elutsk/open-bike-light/README.UA.md

# Open Bike Light - схема та прошивка для ATtiny13A

Прошивка заднього ліхтаря для велоклубу, схема ревізії `circuit2`.
Це переклад файлу `README.md`. Якщо тексти розходяться, правильним вважається англійський.

Документ має дві частини:

1. **Інструкція користувача** - як користуватися ліхтарем.
2. **Інструкція для збирача** - як налаштувати програми, прошити, відкалібрувати й перевірити плату.

Назви меню Arduino IDE наведено англійською, як вони виглядають у мові інтерфейсу за замовчуванням.

---

# Частина 1. Інструкція користувача

## 1.1 Що це

Задній велоліхтар з одним червоним світлодіодом, однією кнопкою і вбудованим
Li-ion акумулятором, який заряджається через USB-C. Ліхтар має 5 режимів світла,
розділених на 2 групи ("блоки"), запам'ятовує останній режим, показує рівень
заряду і сам захищає акумулятор від глибокого розряду.

## 1.2 Кнопка

Кнопка одна. Вона розрізняє три види натискань:

| Натискання | Назва | Як зробити |
|---|---|---|
| Коротке | SP | Натиснути й відпустити швидше ніж за 1 секунду. |
| Подвійне | DP | Два коротких натискання поспіль; друге треба почати не пізніше ніж через 0,3 с після того, як відпустили перше. |
| Довге | LP | Утримувати кнопку 1 секунду. Ліхтар реагує ще поки кнопка натиснута, після цього її можна відпустити. |

Коли ліхтар увімкнений, коротке натискання спрацьовує приблизно через 0,3 с після
відпускання кнопки (ліхтар чекає, чи не буде другого натискання).

## 1.3 Ліхтар вимкнений

| Натискання | Що відбувається |
|---|---|
| SP | Показує рівень заряду (див. 1.5). |
| DP | Нічого особливого (сприймається як два коротких натискання: рівень заряду показується двічі). |
| LP | Вмикає ліхтар у режимі, який використовувався востаннє. Найперший раз вмикається Блок 1, режим 1 (Eco). |

Під час увімкнення спершу перевіряється акумулятор:

1. Заряд нижче 10%: ліхтар вмикається в режимі Eco і лишається в ньому (див. 1.6).
2. Акумулятор порожній: світлодіод дає **один короткий тьмяний спалах**, і ліхтар
   лишається вимкненим. Це означає, що ліхтар справний, але акумулятор треба зарядити.

## 1.4 Ліхтар увімкнений

| Натискання | Що відбувається |
|---|---|
| SP | Наступний режим у поточному блоці (після останнього знову перший). |
| DP | Перехід на інший блок, завжди з його першого режиму. |
| LP | Запам'ятовує поточні блок і режим і вимикає ліхтар. |

### Блок 1 - блимання (найкраще вдень, щоб вас було видно)

| Режим | Назва | Як світить |
|---|---|---|
| 1 | Eco | Один короткий спалах (50 мс) щосекунди. Найменше витрачає акумулятор. |
| 2 | Normal | Серія з трьох коротких спалахів, потім пауза 0,6 с. |
| 3 | Hi-vis | Довгий спалах 0,2 с, пауза 0,4 с. |

### Блок 2 - постійне світло (для групових поїздок, щоб не сліпити того, хто їде позаду)

| Режим | Назва | Яскравість |
|---|---|---|
| 1 | Ride | 50% |
| 2 | Beam | 100% |

Яскравість лишається однаковою, поки акумулятор розряджається від повного до
приблизно 25%. Нижче 25% ліхтар поступово тьмяніє.

## 1.5 Рівень заряду

Коли ліхтар **вимкнений**, зробіть коротке натискання. Основний світлодіод покаже:

| Що видно | Заряд |
|---|---|
| 4 яскраві спалахи | 75..100% |
| 3 яскраві спалахи | 50..75% |
| 2 яскраві спалахи | 25..50% |
| 1 тьмяний спалах | менше 25% - скоро заряджати |

Рівні відповідають реальній кривій розряду Li-ion акумулятора, а не просто лінійній
шкалі напруги, тож "половина" справді означає, що лишилося приблизно пів часу їзди.
Найточніше показання буде, якщо ліхтар перед цим постояв вимкненим хоча б хвилину.

## 1.6 Низький заряд і порожній акумулятор

1. **Нижче 10%** ліхтар сам перемикається в режим Eco і не дає вибрати інші режими,
   доки його не вимкнуть. Так задумано: Eco дає найдовший час, щоб доїхати додому хоч
   з якимось світлом. Якщо ліхтар не реагує на натискання, причина саме в цьому.
   Ваш улюблений режим при цьому все одно запам'ятовується.
2. **Порожній** (акумулятор дійшов до безпечного мінімуму): ліхтар вимикається сам,
   без попереджувального спалаху. Зарядіть акумулятор.

## 1.7 Заряджання

1. Вставте кабель USB-C у ліхтар. Підійде будь-який USB-зарядний пристрій або порт
   комп'ютера, зокрема кабелі USB-C - USB-C.
2. Один маленький індикатор показує "заряджається", інший - "заряджено". Якщо
   акумулятор не підключений, обидва можуть блимати; це нормально.
3. Повне заряджання розрядженого акумулятора триває приблизно 3 години при струмі
   заряду за замовчуванням (175 мА).
4. Користуватися ліхтарем під час заряджання можна, але тоді зарядний контролер
   може так і не визначити, що акумулятор повний. Для нормального повного заряду
   вимкніть ліхтар.

## 1.8 Зберігання

Вимкнений ліхтар майже не споживає енергії і може місяцями лежати в сумці.
Для тривалого зберігання зарядіть його приблизно наполовину (2 або 3 спалахи)
і перевіряйте раз на кілька місяців.

---

# Частина 2. Інструкція для збирача

## 2.1 Правила безпеки - прочитати спершу

1. **Ніколи не живіть плату від програматора.** VCC з'єднаний напряму з Li-ion
   акумулятором. 5 В від програматора йдуть прямо в акумулятор.
   На USBasp зніміть перемичку живлення цілі ("target power"). Тримайте окремий
   клубний ISP-кабель з перерізаним і підписаним дротом VCC. Програматори, які
   лише *вимірюють* напругу цілі (AVRISP mkII, Atmel-ICE), безпечні як є.
2. **Ніколи не програмуйте ф'юзи RSTDISBL і WDTON.** RSTDISBL вимикає ISP (відновити
   чип можна лише високовольтним програматором). WDTON робить неможливим вимкнення
   watchdog перед сном. Налаштування Arduino нижче їх ніколи не встановлюють; не
   редагуйте ф'юзи вручну.
3. Використовуйте **лише захищені акумулятори** (з власною платою захисту).
4. Для найпершого ввімкнення нової плати замість акумулятора використайте
   лабораторний блок живлення 3,7 В з обмеженням струму близько 100 мА.

## 2.2 Що потрібно

1. Комп'ютер з **Arduino IDE 2.3.6**.
2. ISP-програматор: USBasp (зі знятою перемичкою живлення), USBtinyISP (що не
   живить ціль), AVRISP mkII або Atmel-ICE.
3. **Кліпса SOIC-8** з кабелем до 6- або 10-контактного ISP-роз'єму програматора.
4. Заряджений захищений Li-ion акумулятор, підключений до плати (під час
   програмування плата живиться від власного акумулятора).
5. Мультиметр (для калібрування).

## 2.3 Встановлення програм (один раз на комп'ютер)

1. Встановіть Arduino IDE 2.3.6 з arduino.cc.
2. Відкрийте **File > Preferences**. У полі **Additional boards manager URLs** додайте:
   `https://mcudude.github.io/MicroCore/package_MCUdude_MicroCore_index.json`
   (якщо там уже є адреса, додайте нову з нового рядка). Натисніть OK.
3. У тому ж вікні Preferences поставте галочку **Show verbose output during: upload**.
   Вона знадобиться для калібрування.
4. Відкрийте **Tools > Board > Boards Manager**, знайдіть **MicroCore**, виберіть
   версію **2.5.2** і натисніть Install.
5. У Windows для USBasp може знадобитися USB-драйвер (наприклад, встановлений
   програмою Zadig, драйвер "libusbK" або "WinUSB"). У Linux може знадобитися
   правило udev, щоб працювати з програматором без root.

## 2.4 Відкриття проєкту

1. Папка має називатися `OpenBikeLight` і містити `OpenBikeLight.ino`
   (Arduino вимагає, щоб назви папки й .ino-файлу збігалися).
2. Відкрийте `OpenBikeLight.ino` в Arduino IDE.

## 2.5 Параметри конкретної збірки

На початку `OpenBikeLight.ino` є блок **PER-BUILD PARAMETERS**. Перевіряйте його
для кожної збірки. Усе нижче рядка "INTERNALS" лишається без змін.

| Параметр | За замовчуванням | Значення |
|---|---|---|
| `LED_VF_MV` | 2300 | Пряма напруга основного світлодіода в мВ при робочому струмі. Червоні світлодіоди: 2100..2400. |
| `LED_VFULL_MV` | 3720 | Напруга акумулятора, при якій світлодіод досягає повної яскравості на 100% ШІМ. R9 розраховується саме для цієї напруги. Тримайте рівною `BAT_25_MV`, якщо немає вагомої причини інакше. |

### Вибір R9

R9 - єдина деталь, яку збирач змінює під свій світлодіод. Виберіть бажаний
струм світлодіода (`I`, в амперах) і порахуйте:

`R9 = (LED_VFULL_MV - LED_VF_MV) / 1000 / I`

Приклад: червоний світлодіод 1 Вт, Vf = 2,3 В, 150 мА: R9 = (3,72 - 2,30) / 0,150 = 9,5 Ом,
беремо 10 Ом (виходить 142 мА).

Потім перевірте дві речі:

1. **Піковий струм світлодіода** при повному акумуляторі: `(4,2 - Vf) / R9`. Для
   10 Ом це 190 мА. Світлодіод має витримувати такий імпульсний струм.
2. **Нагрів R9**: `I x (4,2 - Vf)` ват, найгірший випадок при повному акумуляторі.
   Для 10 Ом: 0,142 x 1,9 = 0,27 Вт. Використовуйте резистор 2512 (або два
   послідовно, щоб розподілити тепло).

Типові струми світлодіодів (якщо не впевнені, беріть менше значення):

| Тип світлодіода | Струм на один світлодіод |
|---|---|
| 5 мм, вивідний | 20 мА |
| SMD 3528 | 20 мА |
| SMD 5050 (3 кристали) | 60 мА |
| "Піранья" / superflux, 4 ніжки | 50..70 мА |
| SMD 2835 | 60..150 мА |
| 0,5..1 Вт на "зірці" | 150..350 мА |

Приклад для 5 мм червоного світлодіода на 20 мА, Vf = 2,0 В: R9 = (3,72 - 2,00) / 0,020 =
86 Ом, беремо 82 або 91 Ом, а `LED_VF_MV` встановлюємо 2000.

**Резистор 10 Ом за замовчуванням спалить маленькі світлодіоди (5 мм, 3528).**
Завжди спершу підберіть R9.

Якщо кілька світлодіодів увімкнені паралельно, кожному потрібен свій резистор.

## 2.6 Налаштування Arduino - мають бути точними

Підключіть програматор до комп'ютера, потім у меню **Tools** встановіть:

| Меню | Значення |
|---|---|
| Board | MicroCore > **ATtiny13** |
| BOD | **BOD 2.7V** |
| EEPROM | **EEPROM retained** |
| Clock | **9.6 MHz internal osc.** |
| Bootloader | **No bootloader** |
| Programmer | ваш програматор, наприклад **USBasp** (не "slow") |

Ці налаштування визначають ф'юзи: low fuse **0x3A**, high fuse **0xFB**.

**Важливо:** у MicroCore кожен "Upload Using Programmer" знову записує ф'юзи з цих
меню, не лише "Burn Bootloader". Якщо під час завантаження якесь меню виставлене
неправильно, чип отримає неправильні ф'юзи. Перевіряйте меню щоразу.

## 2.7 Перевірка компіляції

Натисніть **Verify** (кнопка з галочкою). Наприкінці виводу має бути розмір у flash,
приблизно **996 з 1024 байт**. Якщо пише, що скетч завеликий, щось не так у
налаштуваннях (не та плата чи частота) або змінено код.

## 2.8 Підключення програматора

1. Переконайтеся, що програматор **не** живить плату (розділ 2.1).
2. Підключіть до плати заряджений акумулятор (або лабораторний блок живлення).
3. Надягніть кліпсу SOIC-8 на U1. **Перший контакт** кліпси (зазвичай червоний
   дріт) має бути на ніжці 1 ATtiny13A (кут з крапкою на корпусі). Кліпса має
   сидіти рівно, всі 8 контактів на ніжках.
4. Під час програмування світлодіод може блимати. Це нормально: лінія MOSI - це
   також затвор транзистора світлодіода.

## 2.9 Перше програмування нового чипа

Виконайте ці кроки саме в такому порядку, один раз для кожного нового чипа:

1. **Tools > Burn Bootloader.** З "No bootloader" це лише записує ф'юзи
   (9,6 МГц, BOD 2,7 В, EEPROM retained). Також стирає чип.
   Дочекайтеся "Done burning bootloader".
2. **Sketch > Upload Using Programmer** (Ctrl+Shift+U). Дочекайтеся "Done uploading".
   Не користуйтеся звичайною кнопкою "Upload".
3. Зніміть кліпсу.
4. Відкалібруйте (розділ 2.11).
5. Перевірте (розділ 2.12).

## 2.10 Оновлення прошивки згодом

Лише крок 2 з 2.9: **Sketch > Upload Using Programmer**, з меню, встановленими як у 2.6.
Калібрування і збережений режим лишаються в EEPROM завдяки "EEPROM retained".

## 2.11 Калібрування (один раз на плату)

### Навіщо

ATtiny13A міряє акумулятор відносно внутрішнього опорного джерела 1,1 В. Це
джерело відрізняється від чипа до чипа до +-10%. Без калібрування показання
акумулятора може помилятися до 0,4 В, і тоді неправильно працюють індикатор заряду,
перемикання на низький заряд і відсічка. Одне число в EEPROM це виправляє.

### Як це працює

Щоразу, коли ви робите коротке натискання при вимкненому ліхтарі (індикація заряду),
прошивка зберігає в EEPROM своє сире показання акумулятора (`SUM`). Ви міряєте той
самий акумулятор мультиметром, зчитуєте `SUM` з чипа програматором, рахуєте
калібрувальний коефіцієнт `SCALE` і записуєте його назад.

### Крок 1 - знайдіть свою команду avrdude

Усередині Arduino IDE є avrdude. Найпростіше отримати правильну команду так:

1. Переконайтеся, що "Show verbose output during upload" увімкнено (розділ 2.3).
2. Зробіть "Upload Using Programmer".
3. У вікні виводу знайдіть довгий рядок, що починається зі шляху до `avrdude` і
   містить `-C` та `-p attiny13a` (або `-pattiny13a`). Скопіюйте: шлях до avrdude,
   частину `-C...` з файлом конфігурації, частину `-p...` і частину `-c...`
   (програматор).

Далі це позначено так:

```
"<AVRDUDE>" "-C<CONFIG>" -pattiny13a -c<PROGRAMMER>
```

Замініть це тим, що ви скопіювали. Команди запускайте в терміналі
(Windows: Command Prompt; macOS/Linux: Terminal).

### Крок 2 - зніміть показання

1. Зніміть кліпсу. Акумулятор підключений, ліхтар **вимкнений**.
2. Зачекайте щонайменше хвилину після того, як ліхтар востаннє світив.
3. Виміряйте напругу акумулятора мультиметром **прямо на контактах акумулятора**
   на платі (BT1 + і -). Запишіть її в **мілівольтах**, наприклад 3987 мВ.
   Використовуйте мультиметр, що показує щонайменше 3 знаки після коми у вольтах.
4. Зробіть **одне коротке натискання**. Світлодіод покаже рівень заряду, і в цей
   самий момент прошивка збереже `SUM` в EEPROM.
5. Виміряйте напругу ще раз. Якщо вона відрізняється від першого значення, візьміть
   середнє.

### Крок 3 - зчитайте SUM з чипа

1. Надягніть кліпсу (програматор не живить плату).
2. Виконайте:

```
"<AVRDUDE>" "-C<CONFIG>" -pattiny13a -c<PROGRAMMER> -U eeprom:r:eeprom.txt:h
```

3. Відкрийте `eeprom.txt` (він у папці, з якої ви запускали команду). Там 64 байти
   EEPROM по порядку, починаючи з байта 0, приблизно так (точне розбиття на рядки
   може відрізнятися в різних версіях avrdude):

```
0xff,0xff,0x8a,0x0c,0x03,0xff,...
```

Байти 0 і 1 - калібрувальний коефіцієнт (0xff,0xff = ще не відкалібровано),
**байти 2 і 3 - це SUM** (молодший байт першим), байт 4 - збережений режим світла.

У цьому прикладі SUM = 0x0C8A. Переведіть у десяткову систему: 0x0C8A = 3210
(калькулятор Windows у режимі "Програміст" це вміє).

### Крок 4 - порахуйте SCALE

```
SCALE = Vbat_мВ x 16384 / SUM
```

Приклад: 3987 x 16384 / 3210 = 20350 (округліть до цілого).

**Перевірка:** SCALE має бути між **17874 і 23518**. Номінальне значення 20696.
Значення поза цим діапазоном означає помилку (не та одиниця напруги, переплутані
байти, неправильне показання); прошивка ігнорує таке значення і використовує
номінальне опорне джерело.

Переведіть SCALE у шістнадцяткову систему: 20350 = 0x4F7E. **Молодший байт** 0x7E,
**старший байт** 0x4F.

### Крок 5 - запишіть SCALE

```
"<AVRDUDE>" "-C<CONFIG>" -pattiny13a -c<PROGRAMMER> -U eeprom:w:0x7E,0x4F:m
```

Спершу молодший байт, потім старший. Це записує адреси EEPROM 0 і 1. Деякі версії
avrdude при цьому можуть скинути інші байти EEPROM (збережений режим, SUM); це
нешкідливо, просто наступного разу ліхтар увімкнеться в Eco.

### Крок 6 - перевірте

1. Ще раз зчитайте EEPROM (крок 3) і перевірте, що байти 0 і 1 - ваші значення.
2. Зніміть кліпсу. Коли avrdude закінчує роботу, він відпускає RESET, тож чип сам
   перезапускається і зчитує новий калібрувальний коефіцієнт.
3. Зробіть коротке натискання при вимкненому ліхтарі і перевірте, що кількість
   спалахів відповідає показанню мультиметра і таблиці в 2.13.

Запишіть значення SCALE на платі. Якщо чип колись втратить вміст EEPROM, те саме 
значення можна записати знову без вимірювань.

## 2.12 Перевірка після збирання

1. **Струм сну.** Ліхтар вимкнений, мультиметр у діапазоні мкА послідовно з
   акумулятором. Через кілька секунд має бути менше приблизно 1 мкА (плюс власне
   споживання плати захисту акумулятора, якщо міряєте поза нею). Значно більше
   значення означає перемичку з припою або неправильну деталь, найчастіше біля
   дільника (R11, R7) або в частині USB-C/зарядного контролера.
2. **Індикація заряду.** Коротке натискання: 1..4 спалахи, як у 1.5.
3. **Увімкнення.** Довге натискання: Eco (першого разу).
4. **Усі режими.** Короткі натискання перебирають Eco > Normal > Hi-vis; подвійне
   натискання переводить у Ride; коротке Ride > Beam.
5. **Пам'ять.** Вимкнути довгим натисканням у Beam, увімкнути довгим натисканням:
   вмикається в Beam.
6. **Тепловий тест.** Режим Beam 15 хвилин із закритим корпусом. Має бути комфортно
   теплим, а не гарячим. Якщо гріється сильно, збільште R9.
7. **Заряджання.** Підключіть USB-C, має засвітитися індикатор заряджання.

## 2.13 Пороги заряду

Прошивка використовує такі напруги акумулятора (defines на початку .ino):

| Define | мВ | Значення |
|---|---|---|
| `BAT_75_MV` | 3970 | від цього значення і вище - 4 спалахи |
| `BAT_50_MV` | 3850 | від цього значення і вище - 3 спалахи |
| `BAT_25_MV` | 3720 | від цього значення і вище - 2 спалахи, нижче - 1 тьмяний спалах |
| `BAT_10_MV` | 3650 | нижче - тільки Eco |
| `BAT_CUTOFF_MV` | 3100 | нижче - вимкнення (порожній) |

Пороги відповідають типовій кривій напруги холостого ходу Li-ion акумулятора. Ті самі
пороги використовуються і для вимірювань у спокої (індикація заряду, увімкнення), і
під навантаженням (під час їзди). Відсічка на 3,1 В лишає запас на холодну погоду;
плата захисту самого акумулятора - останній рівень захисту нижче цього.

## 2.14 Пошук несправностей

| Проблема | Ймовірна причина і що робити |
|---|---|
| avrdude: "target doesn't answer", "initialization failed" | Кліпса сидить погано або перевернута; акумулятор не підключений; занадто швидкий SCK програматора (для USBasp спробуйте додати до команди `-B 32` або один раз зробити Burn Bootloader з програматором "USBasp slow" в Arduino). |
| avrdude: "device signature = 0x000000" | Те саме, що вище. Перевірте кожен контакт кліпси. |
| Скетч завеликий | Не та плата (має бути MicroCore ATtiny13) або змінений код. |
| Світлодіод ніколи не світить, індикація заряду нічого не показує | Акумулятор порожній або нижче відсічки; обрив R9; не припаяний Q1; світлодіод навпаки. |
| Світлодіод постійно світить на повну | Пробитий Q1 або відсутній R10. Негайно відключіть акумулятор. |
| Рівень заряду завжди неправильний | Не відкалібровано, або SCALE поза допустимим діапазоном (тоді використовується номінал). Повторіть 2.11. |
| Увімкнений ліхтар не реагує на кнопку | Заряд нижче 10%: тільки Eco (див. 1.6). Зарядіть. |
| Ліхтар сам вимикається | Акумулятор порожній. Зарядіть. |
| Після завантаження зникли збережений режим і калібрування | У меню EEPROM було "EEPROM not retained". Встановіть "EEPROM retained", один раз зробіть Burn Bootloader, завантажте прошивку, відкалібруйте знову (або запишіть відомий SCALE). |
| На холоді ліхтар перезапускається або мерехтить | Холодний або старий акумулятор просідає під навантаженням нижче рівня BOD (2,7 В). Візьміть кращий акумулятор або більший R9. |

---

# Частина 3. Як працює прошивка

Ця частина для тих, хто підтримує або адаптує код.

## 3.1 Загальна схема

1. Тактова частота 9,6 МГц від внутрішнього RC-генератора. Timer0 працює в режимі
   fast PWM з дільником 8: ШІМ 4,69 кГц на OC0A (PB0), значно вище за видиме мерехтіння.
2. Між переповненнями Timer0 процесор спить у режимі **idle**; 47 переповнень
   складають один **тік 10 мс**. Увесь відлік часу (кнопка, патерни, перевірки
   акумулятора) ведеться в тіках.
3. Коли ліхтар вимкнений і роботи немає, MCU переходить у **power-down**: світлодіод
   вимкнений, дільник вимкнений, АЦП вимкнений, Timer0 зупинений, watchdog вимкнений,
   BOD вимкнений на час сну (часова послідовність через BODCR). Розбудити його може
   лише зміна стану кнопки.
4. Будь-яке скидання (увімкнення живлення, brown-out, watchdog, зовнішнє) закінчується
   у вимкненому стані. Ще до запуску `main()` функція `earlyInit()` (секція `.init3`)
   очищає MCUSR і зупиняє watchdog, тож скидання від watchdog не може спричинити
   цикл скидань. Після скидання всі піни у високоімпедансному стані, і R10 тримає
   MOSFET закритим без жодного коду.
5. Поки MCU не спить, watchdog працює з таймаутом 2 с і скидається лише в головному
   циклі, раз на тік. Якщо прошивка зависне, чип перезапуститься, і світлодіод згасне.

## 3.2 Піни

| Ніжка | Порт | Призначення |
|---|---|---|
| 1 | PB5 | RESET, підтяжка 10 кОм (потрібна для ISP) |
| 2 | PB3 | Кнопка на GND, внутрішня підтяжка, пробудження за зміною стану |
| 3 | PB4 | ADC2, середня точка дільника акумулятора, цифровий вхід вимкнений |
| 5 | PB0 | ШІМ OC0A на затвор MOSFET |
| 6 | PB1 | Не підключений, увімкнена внутрішня підтяжка (щоб вхід не висів у повітрі) |
| 7 | PB2 | Вмикання дільника: високий рівень, поки MCU не спить, низький у сні |

## 3.3 Кнопка

Антибрязкіт: вхід має бути стабільним 50 мс (`BTN_DEBOUNCE_MS`).
Жести працюють за схемою, яку використовують бібліотека OneButton і прошивка
ліхтариків Anduril:

1. Час довгого натискання (`BTN_LP_MS`, 1000 мс) рахується від моменту натискання.
   Довге натискання спрацьовує, поки кнопку ще тримають, зокрема й на другому
   натисканні подвійного.
2. Вікно подвійного натискання (`BTN_DP_WINDOW_MS`, 300 мс) рахується від відпускання
   першого натискання. Подвійне натискання спрацьовує на другому відпусканні.
3. Коли ліхтар увімкнений, коротке натискання фіксується, коли вікно закінчується.
   Коли ліхтар вимкнений, подвійне натискання не має функції, тож коротке
   фіксується одразу при відпусканні.

## 3.4 Вимірювання акумулятора

1. Дільник R11 1 МОм / R7 270 кОм з C4 10 нФ, зчитується на ADC2 відносно
   внутрішнього опорного джерела 1,1 В. Чотири перетворення сумуються (`SUM`,
   0..4092) після одного відкинутого.
2. Напруга: `Vbat_мВ = SUM x SCALE / 16384`. `SCALE` береться з EEPROM
   (калібрування), номінал 20696. Всередині прошивки напруга обробляється кроками по 8 мВ.
3. Ліхтар вимкнений: вимірювання в спокої, при короткому натисканні (індикація
   заряду) і при довгому (увімкнення).
4. Ліхтар увімкнений: приблизно раз на секунду, під навантаженням. У постійних
   режимах у будь-який момент; у блимаючих - в останні 10 мс спалаху. C4 усереднює
   ШІМ 4,69 кГц, тож показання - це середня напруга акумулятора під навантаженням.
5. Нижче `BAT_10_MV` ліхтар примусово переходить в Eco до вимкнення (з фіксацією,
   щоб напруга, яка відновлюється в Eco, не перемикала режими туди-сюди).
   Нижче `BAT_CUTOFF_MV` ліхтар вимикається.

## 3.5 Компенсація яскравості

R9 вибирається так, щоб повна яскравість була при `LED_VFULL_MV`. При вищій напрузі
акумулятора піковий струм більший, тому коефіцієнт заповнення ШІМ зменшується:

`duty = 255 x (LED_VFULL_MV - LED_VF_MV) / (Vbat - LED_VF_MV)`, не більше 255.

Середній струм світлодіода, а отже й яскравість, лишається сталим від повного
заряду до `LED_VFULL_MV`. Інтенсивність 50% - це половина цього duty. Duty
оновлюється при кожному вимірюванні акумулятора.

## 3.6 Патерни

Усе світло (режими, індикація заряду, спалах "порожньо") описане таблицею
`patTable`: тривалість спалаху, пауза між спалахами, кількість спалахів у групі
(плюс прапорець інтенсивності 50%), пауза після групи. Патерн із паузою після групи
повторюється; без паузи - програється один раз. Тривалість спалаху 0 означає
постійне світло. Час задається в тіках по 10 мс.

## 3.7 Карта EEPROM

| Адреса | Розмір | Вміст | Хто записує |
|---|---|---|---|
| 0..1 | 16 біт, молодший байт першим | Калібрувальний коефіцієнт SCALE (допустимо 17874..23518) | Ви, через avrdude |
| 2..3 | 16 біт, молодший байт першим | SUM останньої індикації заряду | Прошивка, при кожному короткому натисканні з вимкненим ліхтарем |
| 4 | 8 біт | Збережений режим світла 0..4 | Прошивка, при вимкненні довгим натисканням |

Номери режимів: 0 Eco, 1 Normal, 2 Hi-vis, 3 Ride, 4 Beam.
EEPROM записується лише тоді, коли значення змінюється.

## 3.8 Розмір прошивки

ATtiny13A має 1024 байти flash. Прошивка займає близько 996 байт. Щоб вміститися:

1. Увесь стан тримається в локальних змінних `setup()`, яка крутить власний
   нескінченний цикл, тож компілятор тримає його в регістрах (`loop()` порожня).
2. Рядок `#pragma GCC optimize` вимикає кілька оптимізацій, що дублюють код.
3. Розрахунки напруги використовують невелике множення зсувами з додаванням і кроки
   по 8 мВ замість 32-бітної арифметики.
4. Переповнення Timer0 лише будить процесор (порожнє переривання); головний цикл
   рахує пробудження.

Будь-яка нова функція потребує економії місця деінде. Після кожної зміни перевіряйте
розмір, який показує Verify.
