elutsk/open-bike-light/media/obl close.jpg

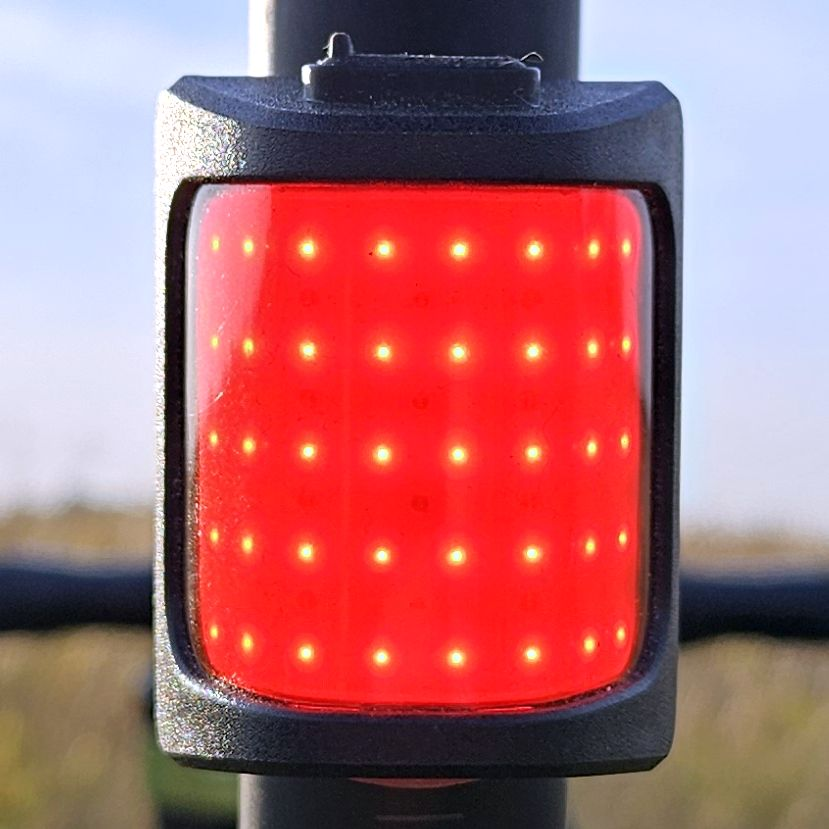
media/obl close.jpg
