elutsk/open-bike-light/media/obl vs cobber.jpg

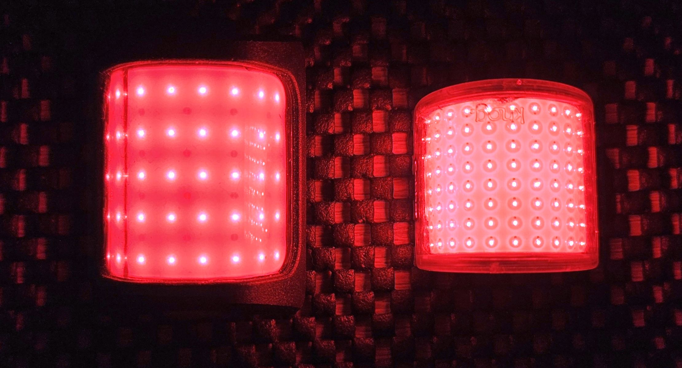
media/obl vs cobber.jpg
