elutsk/open-bike-light/media/on a bike.jpg

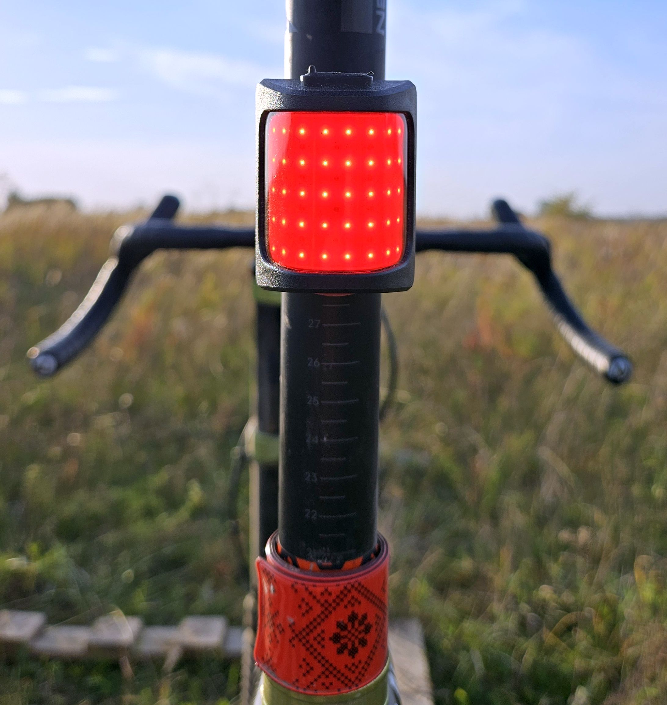
media/on a bike.jpg
