elutsk/open-bike-light/media/proto0.jpg

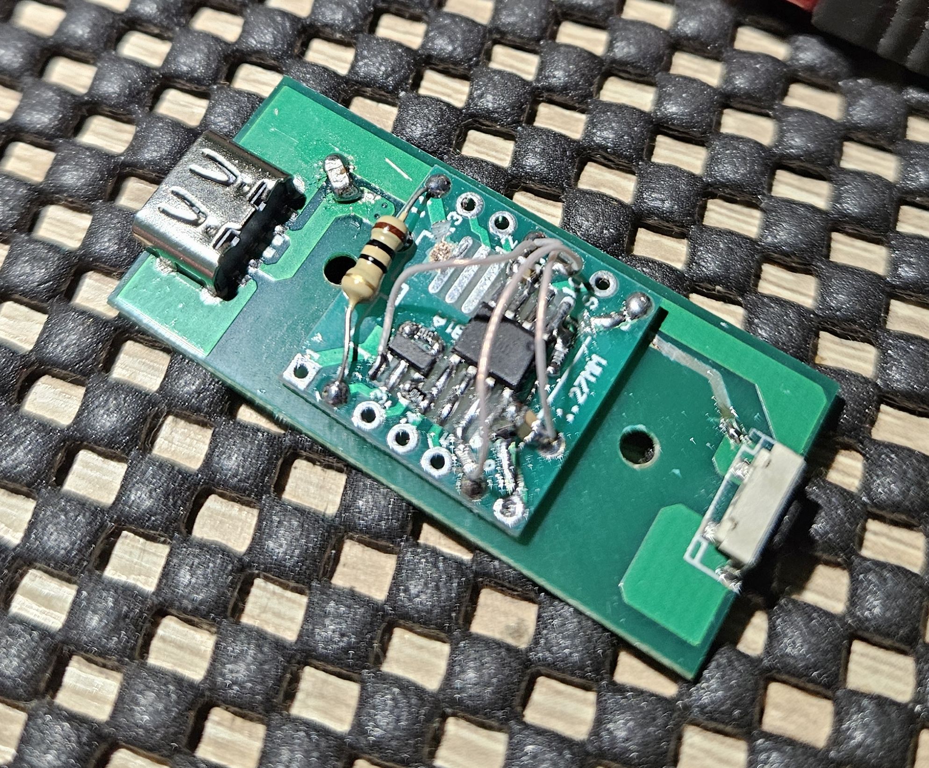
media/proto0.jpg
