elutsk/open-bike-light/media/proto0a.jpg

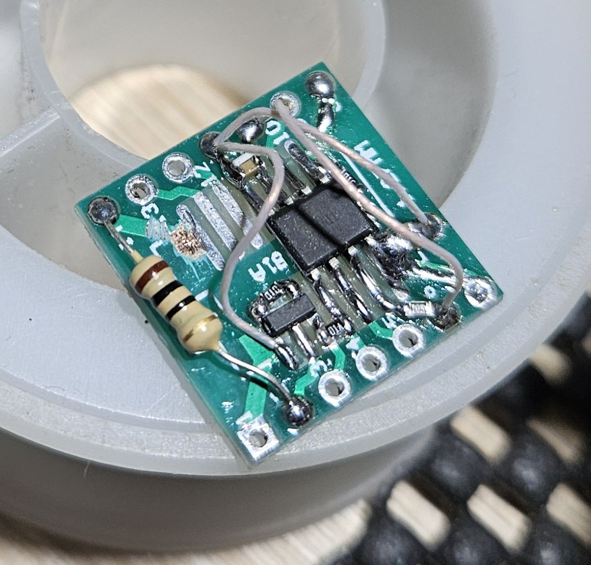
media/proto0a.jpg
