elutsk/open-bike-light/media/proto1.jpg

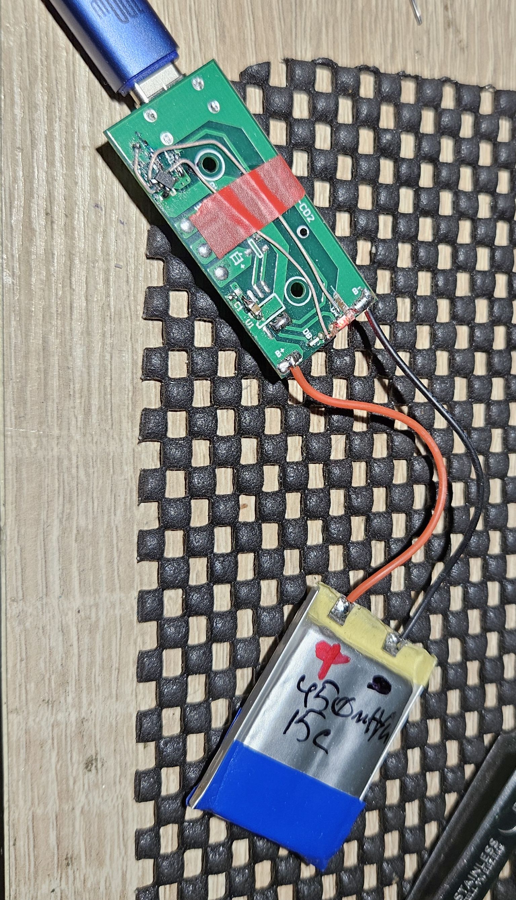
media/proto1.jpg
