elutsk/open-bike-light/media/proto2.jpg

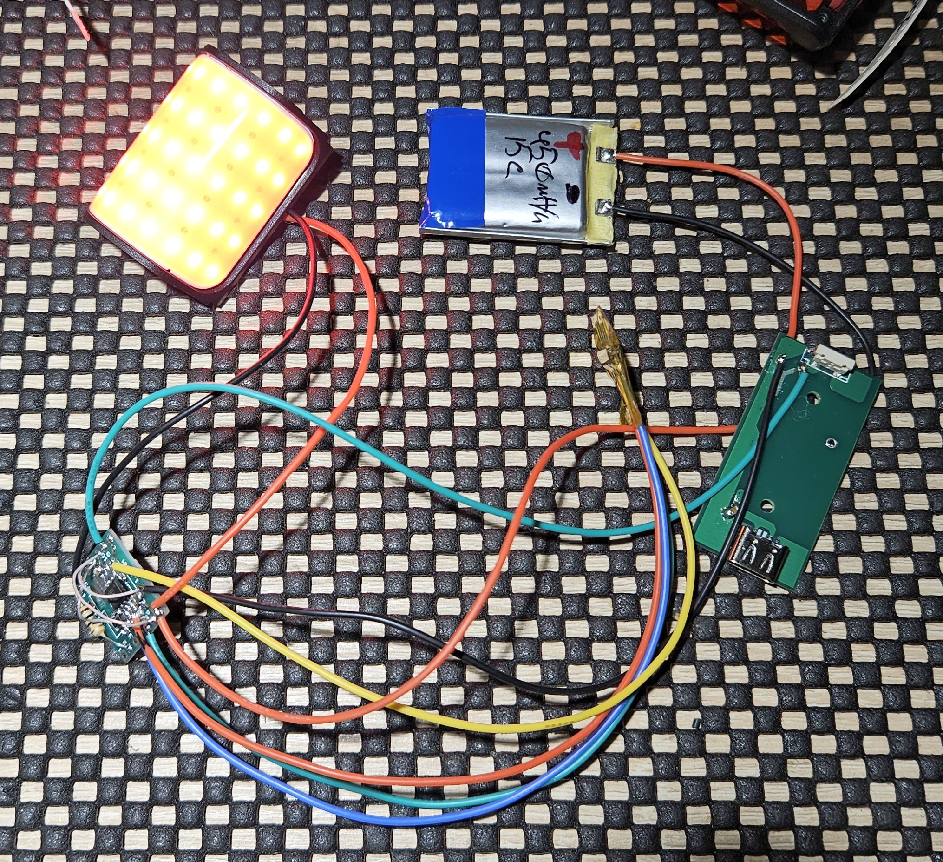
media/proto2.jpg
