elutsk/open-bike-light/media/proto3.jpg

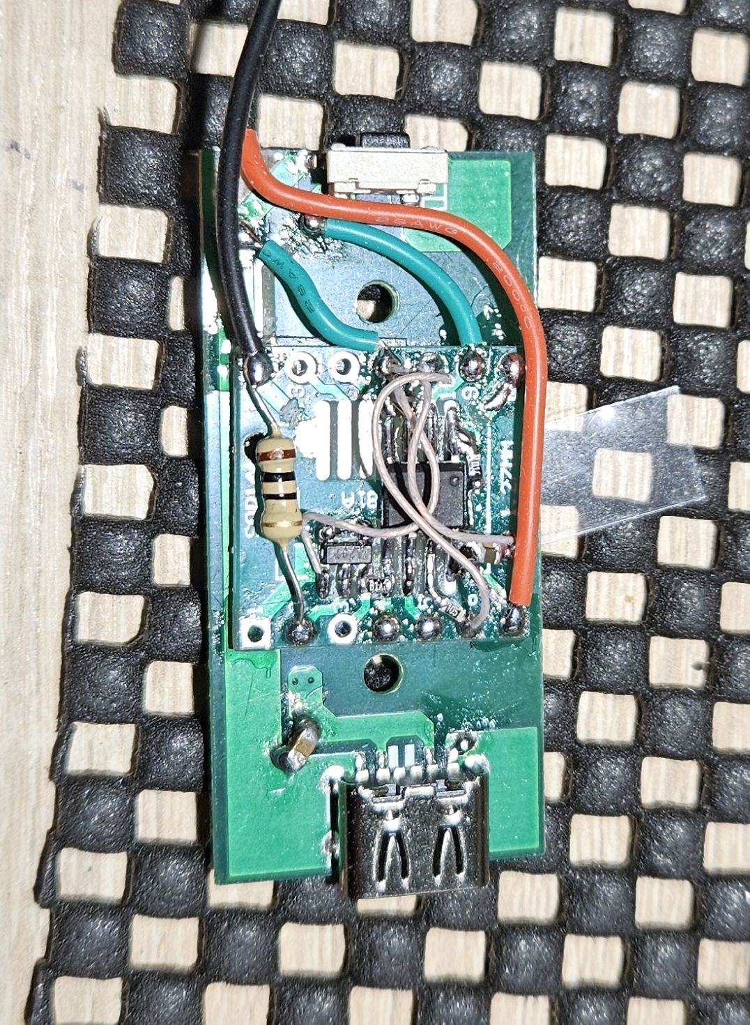
media/proto3.jpg
