elutsk/open-bike-light/media/proto4.jpg

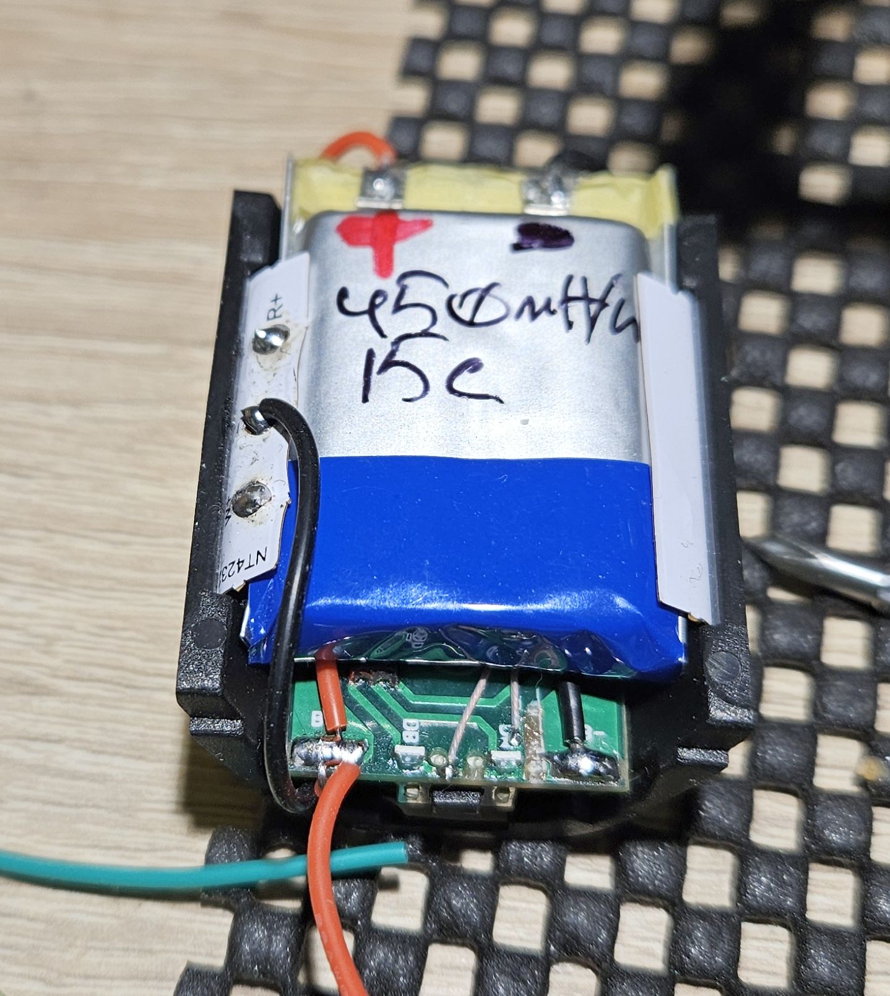
media/proto4.jpg
