elutsk/open-bike-light/media/proto5.jpg

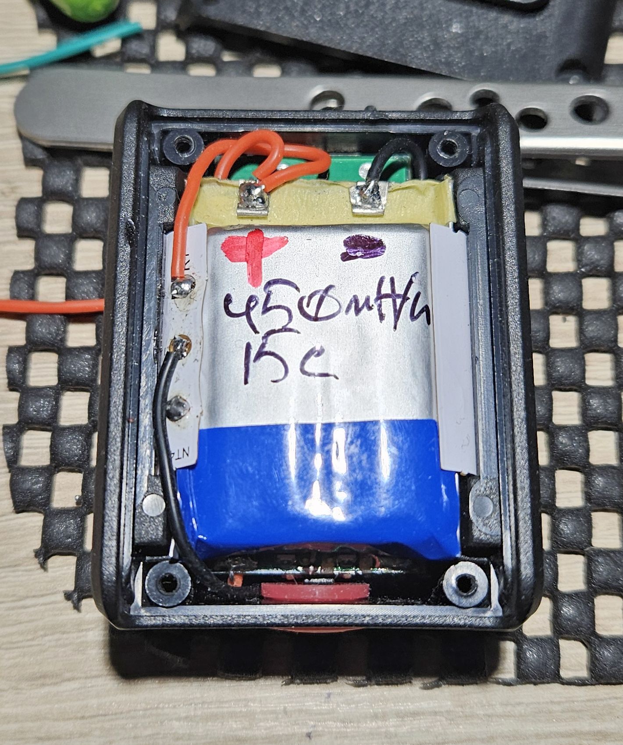
media/proto5.jpg
