elutsk/open-bike-light/circuit/schematic_v1.pdf

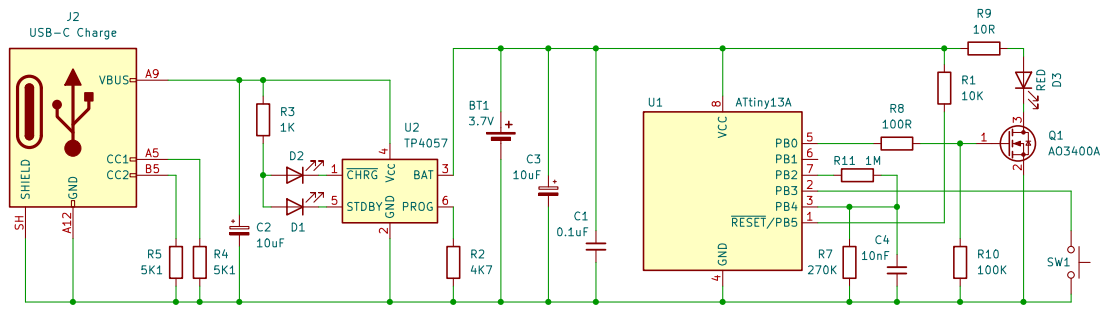
[picture p13: page 1]
