elutsk/open-bike-light/circuit/kicad/OpenBikeLight.kicad_pcb

## KiCad design schema/erasmus.kicad_sch

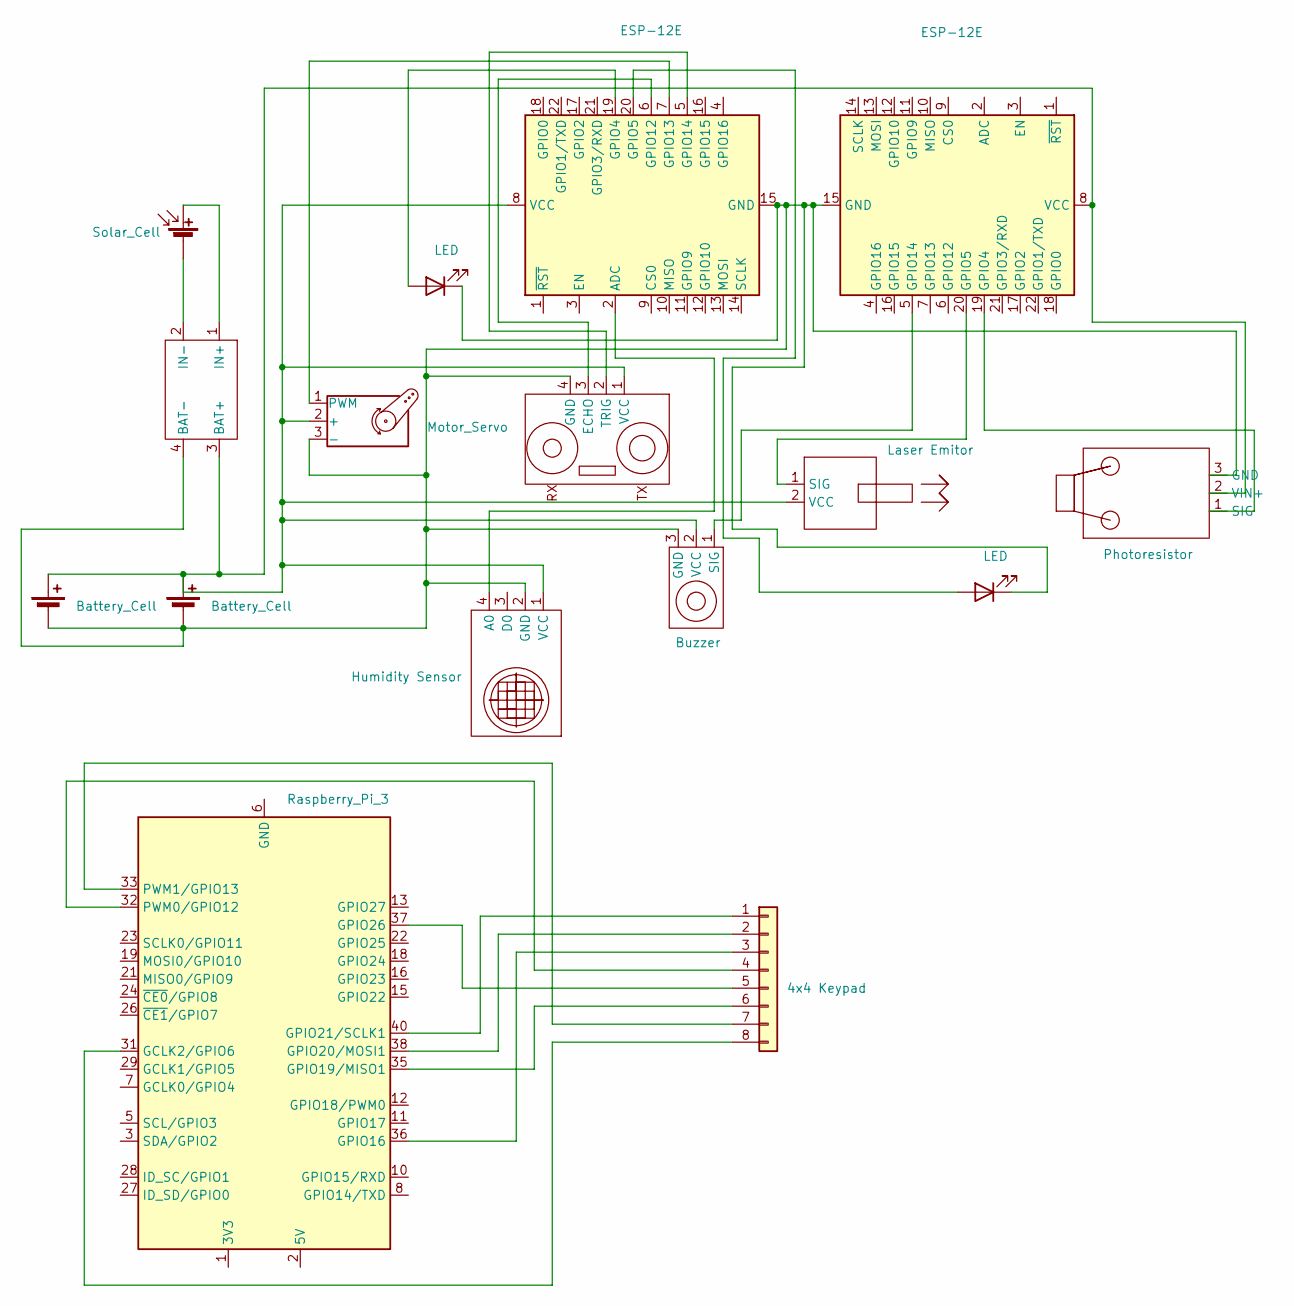
[picture p14: schematic erasmus.kicad_sch]

Parts:
BT1, BT2: Battery_Cell
D1, D2: LED
J1: Raspberry_Pi_3
J2: 4x4 Keypad
M1: Motor_Servo
SC1: Solar_Cell
U1, U2: ESP-12E
U3: Laser Emitor
U4: Photoresistor
U5: Buzzer
U6, U7: (no value)
U8: Humidity Sensor

Connections:
unnamed: BT1.1 (+), BT2.1 (+), M1.2 (+), U1.8 (VCC), U2.8 (VCC), U3.2 (VCC), U4.2 (VIN+), U5.2 (VCC), U6.1 (VCC), U7.3 (BAT+), U8.1 (VCC)
unnamed: BT1.2 (-), BT2.2 (-), D1.1 (K), D2.1 (K), M1.3 (-), U1.15 (GND), U2.15 (GND), U4.3 (GND), U5.3 (GND), U6.4 (GND), U7.4 (BAT-), U8.2 (GND)
unnamed: D1.2 (A), U1.19 (GPIO4)
unnamed: D2.2 (A), U1.20 (GPIO5)
unnamed: J1.1 (3V3), J1.17 (3V3)
unnamed: J1.2 (5V), J1.4 (5V)
unnamed: J1.6 (GND), J1.9 (GND), J1.14 (GND), J1.20 (GND), J1.25 (GND), J1.30 (GND), J1.34 (GND), J1.39 (GND)
unnamed: J1.31 (GCLK2/GPIO6), J2.8
unnamed: J1.32 (PWM0/GPIO12), J2.4
unnamed: J1.33 (PWM1/GPIO13), J2.7
unnamed: J1.35 (GPIO19/MISO1), J2.6
unnamed: J1.36 (GPIO16), J2.3
unnamed: J1.37 (GPIO26), J2.5
unnamed: J1.38 (GPIO20/MOSI1), J2.2
unnamed: J1.40 (GPIO21/SCLK1), J2.1
unnamed: M1.1 (PWM), U1.7 (GPIO13)
unnamed: SC1.1 (+), U7.1 (IN+)
unnamed: SC1.2 (-), U7.2 (IN-)
unnamed: U1.2 (ADC), U8.4 (A0)
unnamed: U1.5 (GPIO14), U6.2 (TRIG)
unnamed: U1.6 (GPIO12), U6.3 (ECHO)
unnamed: U2.5 (GPIO14), U5.1 (SIG)
unnamed: U2.19 (GPIO4), U4.1 (SIG)
unnamed: U2.20 (GPIO5), U3.1 (SIG)
