elutsk/open-bike-light/(commit log)

2026-10-09 Circuit and firmware added. README updated. Ukrainian readme added
    [OpenBikeLight.kicad_pcb, OpenBikeLight.kicad_sch]
2026-10-09 Circuit and pictures update
